kozachenkoartem/finger-gate-opener/README.md

# Finger Gate Opener

Проект устройства для открытия калитки по отпечатку пальца. В репозитории
хранится 3D-модель корпуса для датчика R558S.

## Прошивка ESP32-C3 SuperMini

Каталог [`firmware/`](firmware/) содержит прошивку ESP-IDF без Arduino:
локальное распознавание R558S, HTTPS-администрирование, Wi-Fi recovery,
постоянный журнал аудита и LAN API для Atlas. GPIO8 служит активным-low
временным выходом открытия на одну секунду; GPIO10 не настраивается до
подключения физического реле.

### Подготовка ESP-IDF

Нужен ESP-IDF 5.x. Ниже пример установки ESP-IDF 5.5.3 в домашний каталог на
Linux:

```sh
mkdir -p ~/esp
git clone --recursive --branch v5.5.3 https://github.com/espressif/esp-idf.git ~/esp/esp-idf-v5.5.3
~/esp/esp-idf-v5.5.3/install.sh esp32c3
```

Перед каждой сборкой откройте новую оболочку и активируйте окружение:

```sh
. ~/esp/esp-idf-v5.5.3/export.sh
```

### Сборка и прошивка

Подключите ESP32-C3 SuperMini к USB-кабелю передачи данных. Определите
последовательный порт, например `ls /dev/ttyACM* /dev/ttyUSB*`; ниже он указан
как `<PORT>`.

```sh
idf.py -C firmware set-target esp32c3
idf.py -C firmware build
idf.py -C firmware -p <PORT> flash
idf.py -C firmware -p <PORT> monitor
```

Чтобы выйти из монитора, нажмите `Ctrl-]`. Ожидаемый результат: строки
диагностики, запуск HTTPS и подключение к сохранённой Wi-Fi сети. GPIO8
используется как индикатор открывания: секундный импульс при разрешённом
совпадении отпечатка или команде Atlas.

### HTTPS-администрирование

После подключения к Wi-Fi откройте `https://finger-gate-XXXX.local/` либо
`https://<IP-платы>/`. Начальные credentials — `admin` / `admin`, с обязательной
заменой пароля. Сертификат устройства самоподписанный. Настройка, API и результаты
проверки описаны в [`docs/https-admin.md`](docs/https-admin.md).

Для доверенного локального хаба Atlas предусмотрен отдельный versioned API с
Bearer-токеном, pinning сертификата устройства, журналом аудита, REST и SSE.
Он доступен только в LAN и не заменяет HTTPS-администрирование. Контракт,
ограничение на одного SSE-клиента, идемпотентные команды калитки и предупреждение
о USB-миграции разделов описаны в [`docs/hub-api.md`](docs/hub-api.md).

Временный recovery AP и смена Wi-Fi без сброса данных описаны в
[`docs/network-recovery.md`](docs/network-recovery.md).

## Датчик отпечатка пальца R558S

R558S — ёмкостный модуль распознавания отпечатков пальцев со встроенной
обработкой и хранением шаблонов. Модуль самостоятельно регистрирует отпечатки
и выполняет поиск совпадений; управляющая плата обменивается командами и
результатами по UART.

| Характеристика | Значение |
| --- | --- |
| Питание и уровни логики | 3.3 В |
| Интерфейс | UART, 57 600 бод |
| Ёмкость базы шаблонов | До 100 отпечатков |
| Диаметр части, проходящей через панель | Около 19 мм (посадочное отверстие в напечатанном корпусе — 19,1 мм) |
| Наружный диаметр буртика | 21 мм (измерено на имеющемся экземпляре) |
| Индикация | Встроенная светодиодная подсветка |

Вход `RX` датчика не рассчитан на 5 В. При подключении к плате с логикой 5 В
нужен преобразователь уровней либо резистивный делитель между `TX` платы и
`RX` датчика. Линии UART подключаются перекрёстно: `TX` датчика к `RX`
контроллера, `RX` датчика к `TX` контроллера.

Ориентир по протоколу и электрическим характеристикам: [руководство R558-S (PDF)](https://cdn-shop.adafruit.com/product-files/4750/R558-S_fingerprint_module_user_manual-V1.1_1___2___1_.pdf).
Перед подключением необходимо сверить распиновку и допустимые напряжения с
документацией конкретной ревизии датчика; цвета проводов сами по себе не
гарантируют правильного подключения.

Для проверки касания подключите модуль при отключённом питании:

| R558S | ESP32-C3 SuperMini |
| --- | --- |
| VCC | 3.3 V |
| GND | GND |
| TX | GPIO4 (RX) |
| RX | GPIO5 (TX) |
| TOUCH_OUT | GPIO3 (вход без внутренней подтяжки) |

Регистрация, роли и удаление доступны через защищённую HTTPS-панель.
Распознавание выполняется локально, независимо от сети; для разрешённого пальца
GPIO8 имитирует секундный импульс реле. Порядок проверки описан в
[`docs/fingerprint-access.md`](docs/fingerprint-access.md).

Проверенный формат протокола и результаты стендовой регистрации описаны в
[`docs/r558s-protocol.md`](docs/r558s-protocol.md).

## Схема подключения R558S к ESP32-C3

[Схема пайки по маркировке платы (SVG)](docs/r558s-esp32c3-wiring.svg) —
расположение выводов соответствует фотографии ESP32-C3 SuperMini, а цвета
проводов — конкретному кабелю R558S из проекта. Соответствие цветов сигналам
пока считается предварительным до успешной проверки UART с датчиком.

Питание датчика — только 3,3 В. Для первых испытаний ESP32 питается от USB;
GPIO10 пока зарезервирован под реле и остаётся неподключённым.

## Корпус датчика

Каталог [`STL/`](STL/) содержит корпус, рассчитанный на установку R558S в
калитке или другой панели. Модель имеет скруглённый внешний контур, центральное
посадочное отверстие под датчик, внутреннюю выборку и полукруглый канал для
кабеля на задней стороне.

| Параметр модели | Значение |
| --- | --- |
| Внешние размеры | 32 × 32 × 14 мм |
| Скругление углов | Радиус 7 мм |
| Отверстие под датчик | Диаметр 19.1 мм |
| Внутренняя выборка | Диаметр 23 мм |
| Толщина передней стенки | 2 мм |
| Кабельный канал | Полукруглый, радиус 1,5 мм, углублён на 0,8 мм относительно предыдущей версии |

### Файлы корпуса

| Файл | Назначение |
| --- | --- |
| [`STL/R558S_case_v3_deeper_round_channel.stl`](STL/R558S_case_v3_deeper_round_channel.stl) | Сетка модели для 3D-печати. |
| [`STL/R558S_case_v3_deeper_round_channel.step`](STL/R558S_case_v3_deeper_round_channel.step) | Геометрия корпуса в STEP для просмотра и доработки в CAD-системах. |
| [`STL/R558S_case_v3_deeper_round_channel.py`](STL/R558S_case_v3_deeper_round_channel.py) | Параметрический исходник CadQuery; изменяйте размеры в константах в начале файла и повторно экспортируйте STL и STEP. |

Для запуска исходника требуется Python с библиотекой CadQuery. Скрипт
перезаписывает STL и STEP с тем же именем в каталоге `STL/`.
