kozachenkoartem/finger-gate-opener/docs/superpowers/plans/2026-11-02-r558s-stage-1.md

# R558S Stage 1 Implementation Plan

> **For agentic workers:** REQUIRED SUB-SKILL: Use superpowers:subagent-driven-development (recommended) or superpowers:executing-plans to implement this plan task-by-task. Steps use checkbox (`- [ ]`) syntax for tracking.

**Goal:** Replace the diagnostic UART exchange with a validated R558S protocol driver and verify its enrollment workflow on the real sensor.

**Architecture:** A platform-independent packet builder and stream parser validate every R558S frame before an ESP-IDF UART adapter exposes command transactions. Only the future fingerprint task may own this adapter; Stage 1 keeps a USB-only diagnostic surface and introduces no Wi-Fi, HTTP, relay, or persistent fingerprint data.

**Tech Stack:** C++17, ESP-IDF 5.5.3 UART driver, FreeRTOS, host CMake/CTest.

**Spec:** The approved Finger Gate Opener plan v2 in the session review record.

## Global Constraints

- UART1: GPIO4 RX, GPIO5 TX, 57,600 baud, 8N1; GPIO3 is `TOUCH_OUT` with no internal pull.
- Treat a response as successful only after header, address, packet type, length, checksum, command status, and command payload validation.
- A command has one absolute deadline; malformed, late, or stale replies cannot confirm a new command.
- Never delete all templates or overwrite an occupied slot during hardware verification.
- Registration timeout is 120 seconds; enrollment image count and LED mode bytes are verified on the actual R558S before later stages depend on them.
- No flash write or board interaction while the board is disconnected.

## Review Focus

- Fragmented UART frames must produce one packet only after all bytes arrive; test in Task 1.
- Garbage before a valid header must not prevent resynchronization; test in Task 1.
- A checksum or length error must be rejected rather than treated as an ACK; test in Task 1.
- A negative confirmation frame must remain distinguishable from a timeout; test in Task 2.
- A timeout after write must not automatically repeat a mutating enrollment or storage command; test in Task 2.

---

### Task 1: Protocol Codec

**Files:**
- Create: `firmware/main/r558s_protocol.hpp`
- Create: `firmware/main/r558s_protocol.cpp`
- Create: `firmware/tests/CMakeLists.txt`
- Create: `firmware/tests/r558s_protocol_test.cpp`

**Interfaces:**
- Produces `r558s::make_command(uint8_t, const std::vector<uint8_t>&)`, `r558s::FrameParser`, and `r558s::Packet`.

- [ ] Write host tests for a known `GetImage` command, fragmented ACK, leading garbage, invalid length, and invalid checksum.
- [ ] Run `cmake -S firmware/tests -B /tmp/opencode/finger-gate-tests && cmake --build /tmp/opencode/finger-gate-tests` and confirm the new tests fail before the codec exists.
- [ ] Implement packet serialization and a bounded resynchronizing parser.
- [ ] Run `ctest --test-dir /tmp/opencode/finger-gate-tests --output-on-failure` and confirm all tests pass.
- [ ] Commit the codec and host tests.

### Task 2: ESP-IDF Transaction Driver

**Files:**
- Create: `firmware/main/r558s_driver.hpp`
- Create: `firmware/main/r558s_driver.cpp`
- Modify: `firmware/main/CMakeLists.txt`
- Modify: `firmware/main/main.cpp`
- Modify: `firmware/tests/r558s_protocol_test.cpp`

**Interfaces:**
- Consumes `r558s::FrameParser` and `r558s::make_command`.
- Produces `r558s::Driver::transact(...)` and typed non-mutating commands used by `main.cpp`.

- [ ] Write tests that classify a confirmation code other than zero as a sensor rejection and distinguish it from parser failure.
- [ ] Run the host test target and confirm the new assertion fails.
- [ ] Implement UART1 initialization, input purge before each transaction, one absolute deadline, and no automatic retry for mutating commands.
- [ ] Replace the diagnostic LED packet code with typed driver calls; retain GPIO8 and TOUCH_OUT diagnostics.
- [ ] Build host tests and `idf.py -C firmware build` without flashing.
- [ ] Commit the driver and diagnostic integration.

### Task 3: Real-Sensor Verification

**Files:**
- Modify: `README.md`
- Modify: `docs/r558s-protocol.md`

- [ ] With the board connected, verify LED commands and command-response parsing.
- [ ] Identify a confirmed free slot without modifying existing templates.
- [ ] Register one test finger with the measured number of scans and 120-second deadline, then search it after reboot.
- [ ] Delete only that test slot and record protocol facts, response shapes, supported LED modes, and measurement results.
- [ ] Commit the verified documentation.
