kozachenkoartem/finger-gate-opener/STL/R558S_case_v3_deeper_round_channel.step

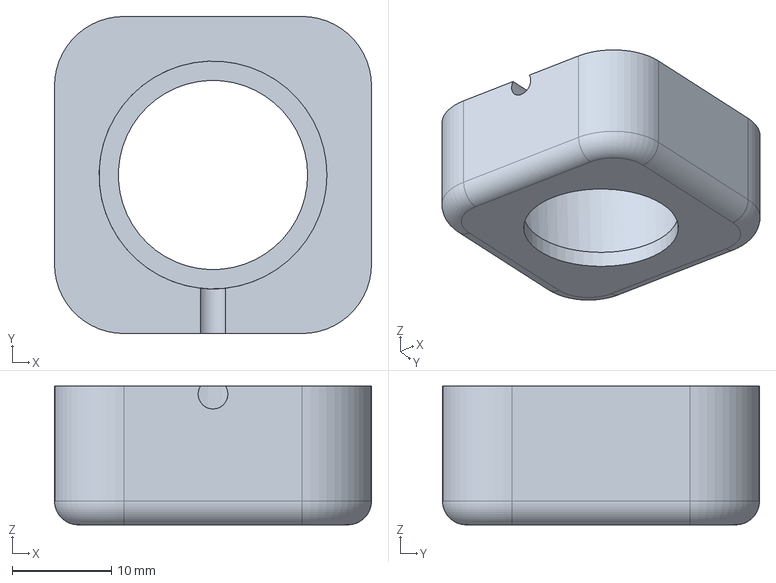
[picture p1: CAD file, 2026-10-20]
STL/R558S_case_v3_deeper_round_channel.step
32.0 x 32.0 x 14.0 mm
