kozachenkoartem/finger-gate-opener/(list of files, cad)

Other CAD files:
STL/R558S_case_v3_deeper_round_channel.stl
