kozachenkoartem/finger-gate-opener/(commit log)

2026-10-20 Add R558S case model
    [R558S_case_v3_deeper_round_channel.step, R558S_case_v3_deeper_round_channel.stl]
2026-10-20 docs: correct R558S sensor type and measured mounting dimensions
2026-11-02 feat: add ESP32-C3 board check firmware
2026-11-02 fix: enforce ESP-IDF C++17 compatibility
    [main.cpp]
2026-11-02 feat: blink ESP32-C3 status LED
2026-11-02 docs: add corrected R558S to ESP32-C3 wiring diagram
2026-11-02 docs: link soldering diagram from README
2026-11-02 feat: add validated R558S protocol driver
2026-11-03 docs: add Finger Gate v1 implementation plan
2026-11-03 feat: add fingerprint access policy
2026-11-03 feat: enroll fingerprints and indicate authorized gate pulses
2026-11-03 feat: add fingerprint enrollment and role controls to admin UI
2026-11-03 docs: record fingerprint firmware boot verification
2026-11-03 fix: accept extended R558S search rejection acknowledgements
    [fingerprint_task.cpp, r558s_driver.cpp, r558s_protocol.cpp, r558s_protocol.hpp, r558s_protocol_test.cpp]
2026-11-03 docs: record fingerprint acceptance and skipped offline test
2026-11-03 feat: add protected recovery AP and safe Wi-Fi switching
2026-11-05 feat: add recoverable audit storage
    [partitions.csv]
2026-11-05 fix: wire hub gate command at startup
    [fingerprint_controller.cpp, main.cpp]
2026-11-05 fix: harden audit hub delivery
    [api_router_test.cpp, audit_events.cpp, audit_events.hpp, audit_store.cpp, audit_store_test.cpp, event_stream_test.cpp, fingerprint_controller.cpp, fingerprint_task.cpp]
2026-11-05 fix: parse hub event cursors
    [api_router.cpp, api_router.hpp]
2026-11-06 fix: allocate audit sectors off task stack
    [audit_store.cpp]
2026-11-06 fix: return named hub command state
    [http_server.cpp]
